nimsara1999/intellimate/pictures/6226648667696248278_121.jpg

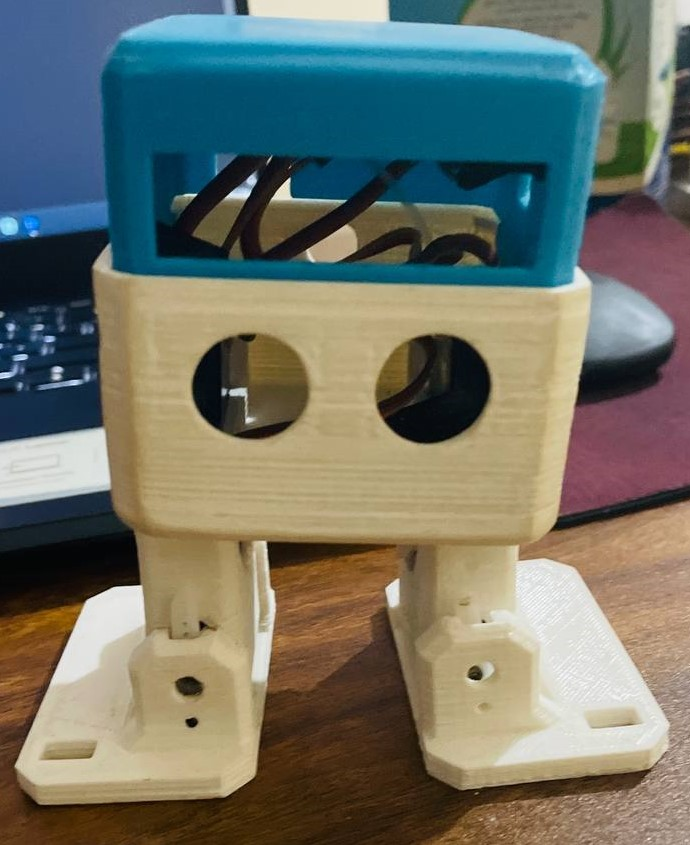
pictures/6226648667696248278_121.jpg
