nimsara1999/intellimate/pictures/Screenshot (5).png

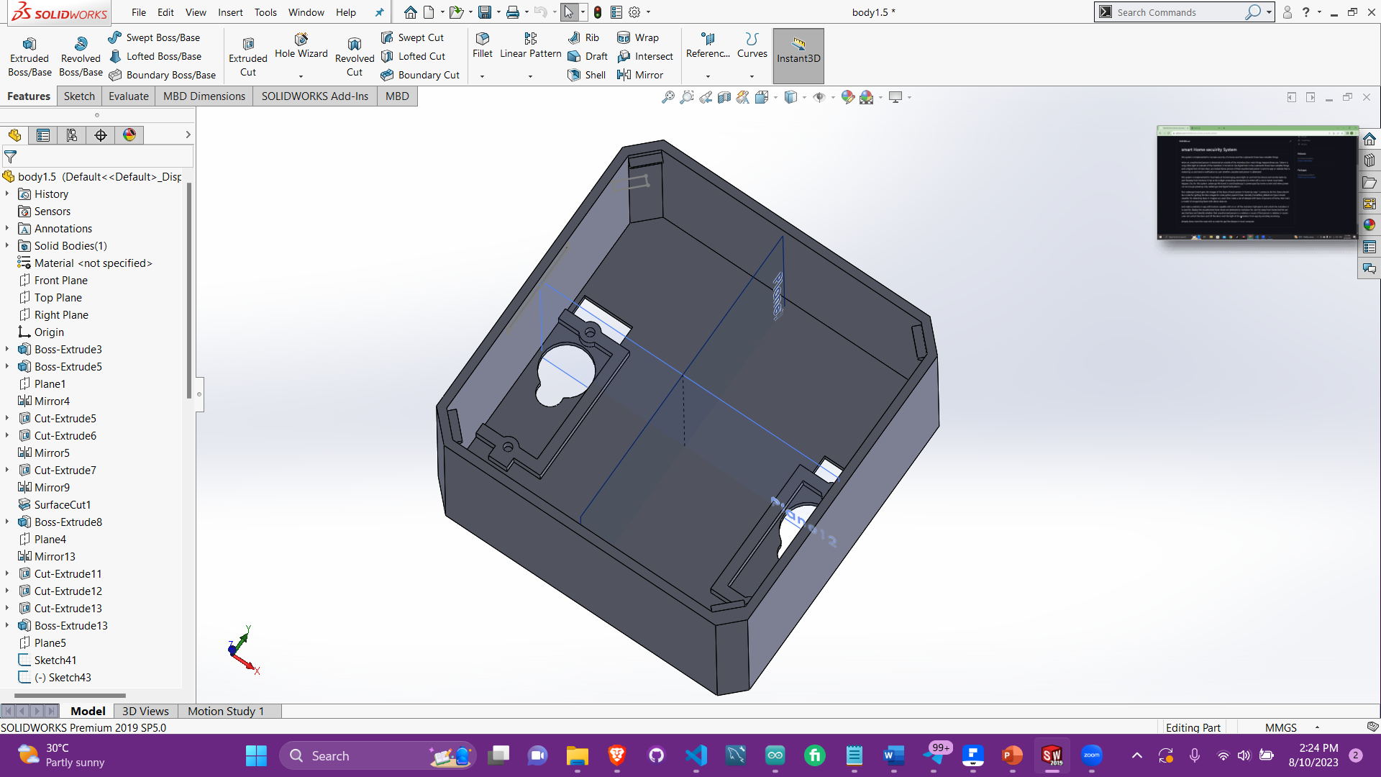
pictures/Screenshot (5).png
