nimsara1999/intellimate/pictures/tensorflowworkflow.png

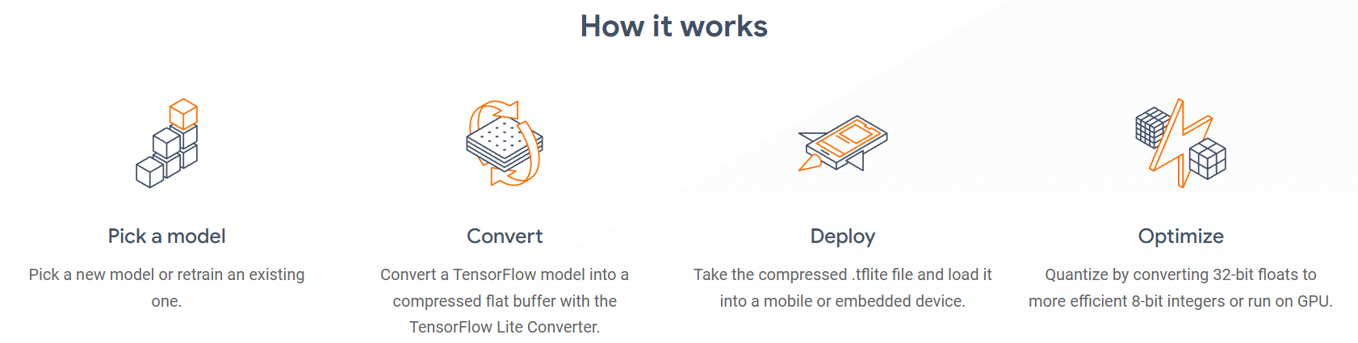
pictures/tensorflowworkflow.png
