nimsara1999/intellimate/solidworks/body/body1.5.SLDPRT

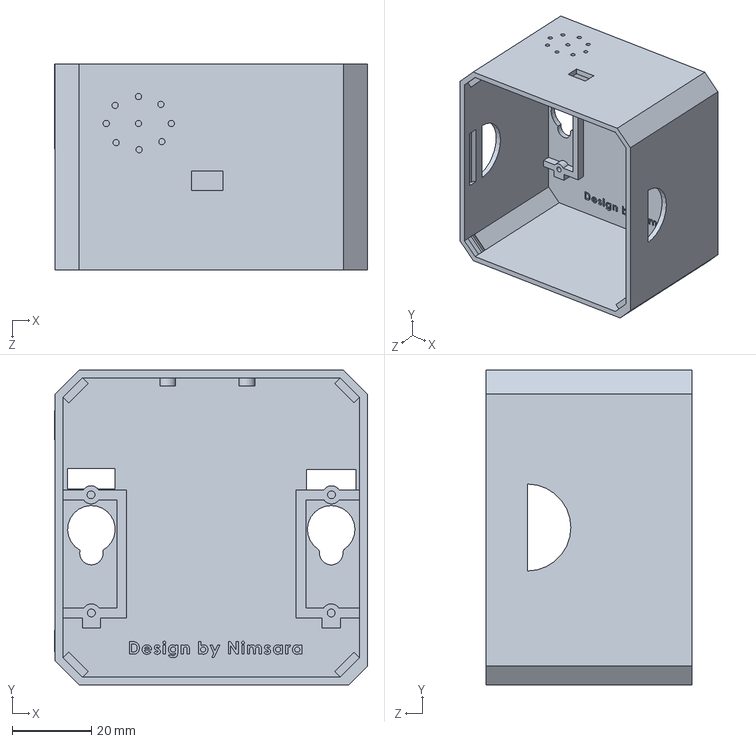
[picture p5: CAD file, 2023-09-29]
solidworks/body/body1.5.SLDPRT
79.2 x 79.7 x 52.0 mm
