nimsara1999/intellimate/solidworks/body/Body1.3part1.sldprt

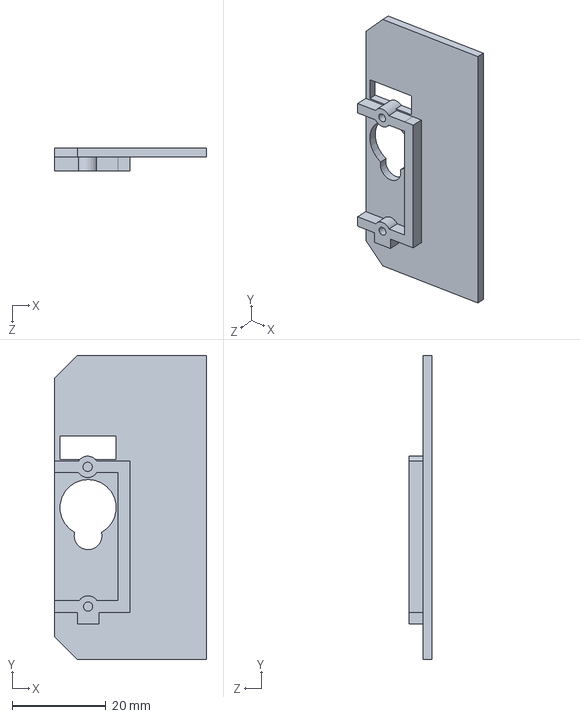
[picture p7: CAD file, 2023-08-12]
solidworks/body/Body1.3part1.sldprt
32.5 x 65.0 x 5.00 mm
