nimsara1999/intellimate/solidworks/body/body1.3.SLDPRT

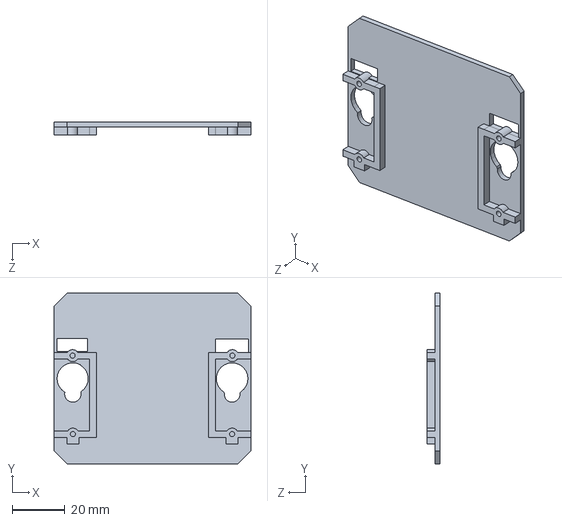
[picture p8: CAD file, 2023-08-12]
solidworks/body/body1.3.SLDPRT
75.0 x 65.0 x 5.00 mm
