nimsara1999/intellimate/solidworks/body/Body1.6.SLDPRT

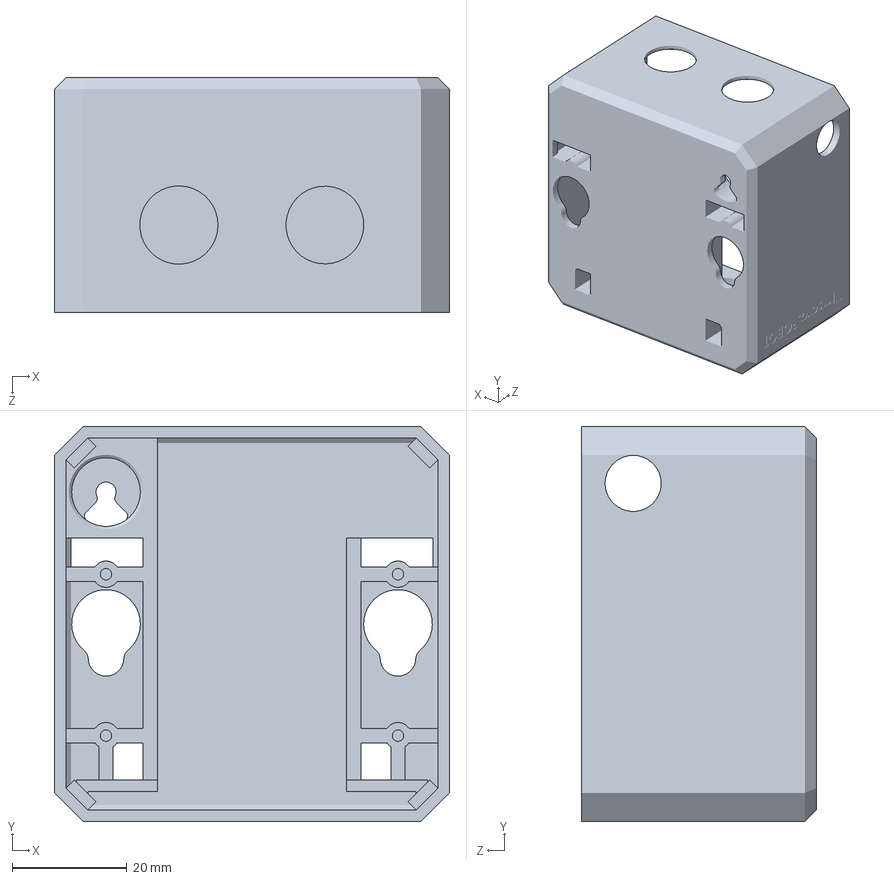
[picture p9: CAD file, 2023-08-12]
solidworks/body/Body1.6.SLDPRT
69.0 x 69.0 x 41.0 mm
