nimsara1999/intellimate/solidworks/body/body1.4.SLDPRT

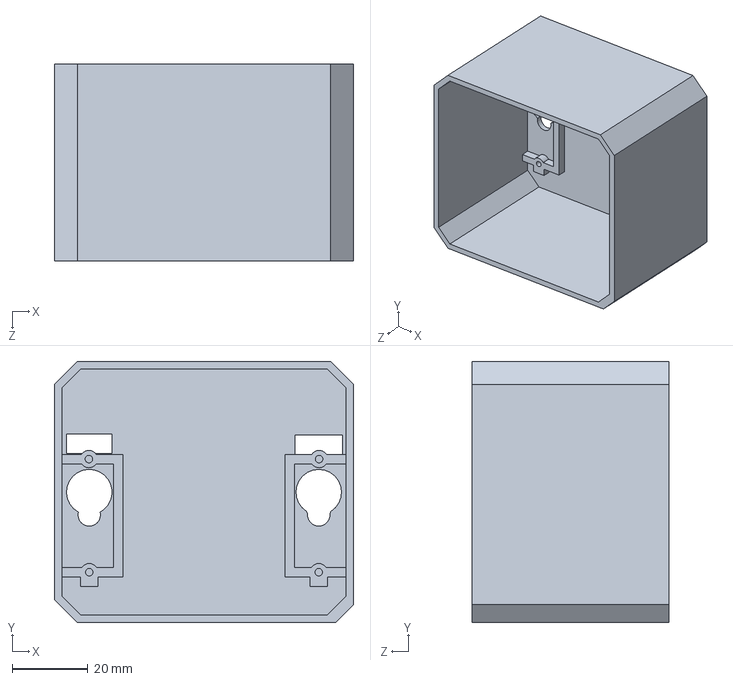
[picture p10: CAD file, 2023-08-12]
solidworks/body/body1.4.SLDPRT
79.0 x 69.0 x 52.0 mm
