nimsara1999/intellimate/solidworks/body/body1.0.SLDPRT

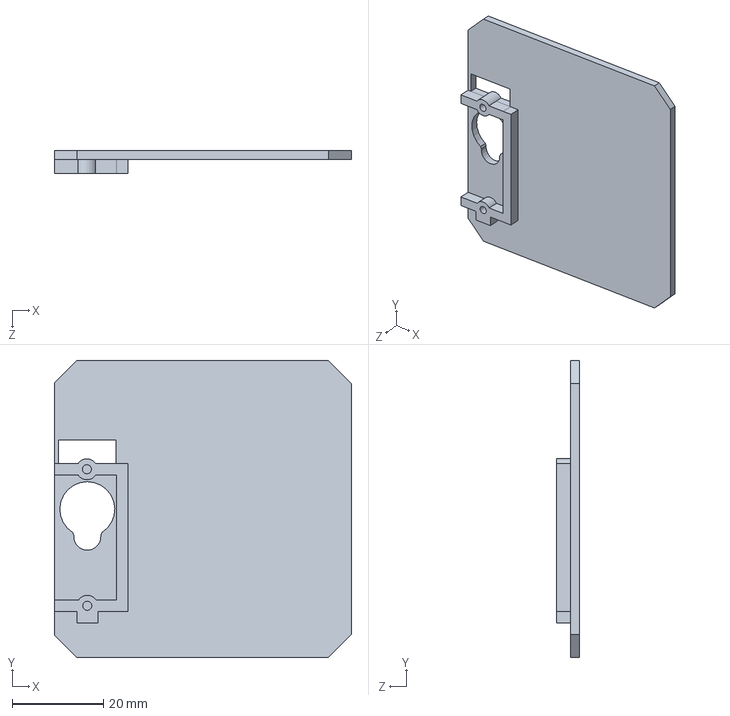
[picture p11: CAD file, 2023-08-12]
solidworks/body/body1.0.SLDPRT
65.0 x 65.0 x 5.00 mm
