nimsara1999/intellimate/(list of files, cad)

Other CAD files:
solidworks/body/Body1.3part2.sldprt
solidworks/body/Body1.1.SLDPRT
