nimsara1999/intellimate/(commit log)

2023-08-12 Initial commit
    initial setup
    [Body1.1.SLDPRT, Body1.3part1.sldprt, Body1.3part2.sldprt, Body1.6.SLDPRT, body1.0.SLDPRT, body1.2.SLDPRT, body1.3.SLDPRT, body1.4.SLDPRT]
2023-09-29 Voice input
    1. Here I take voice input via i2s mic and send to the nodejs server. Then a voice to text model convert them into a text.
    2. Manage chatgpt api in esp32. When entering a text question, answer the answer and read it using an i2s amp and speaker
    [body1.5.SLDPRT]
